RichardBenear/DDScopeX-Hardware/README.md

# DDScope-Hardware
Hardware documentation for Direct Drive Scope

## Book: BUILD A DIRECT DRIVE TELESCOPE: A Comprehensive Guide
Book Available on Amazon [Here](https://a.co/d/0cUrQWGB) 

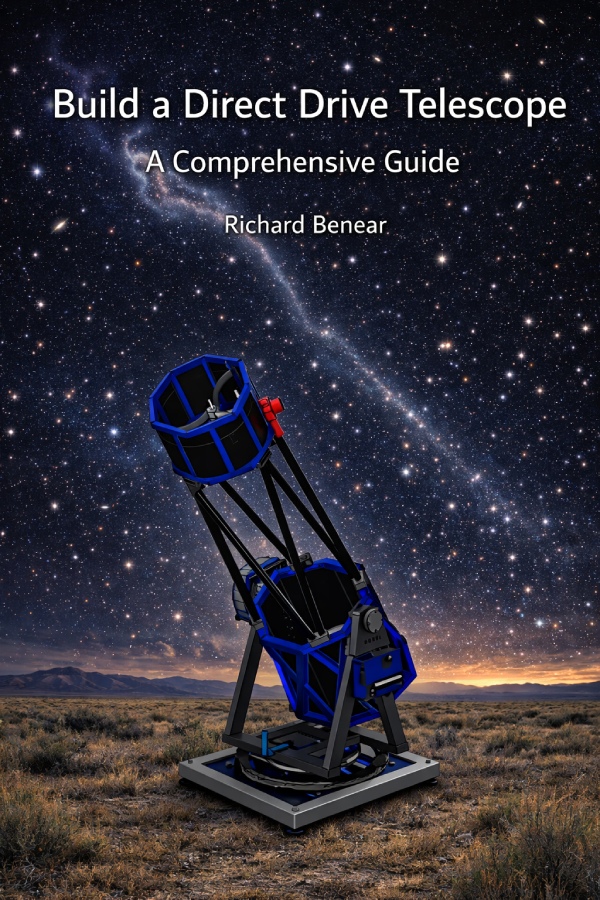
[picture p1: DDScopeXBookFront.jpg]
DDScopeX Book Front
