RichardBenear/DDScopeX-Hardware/ALT_Motor/dualAltMotor.JPG

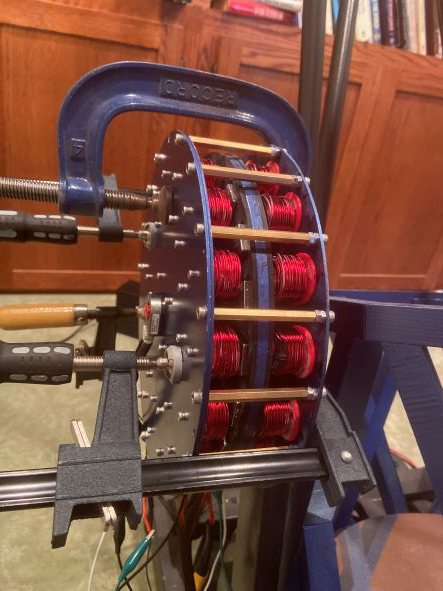
ALT_Motor/dualAltMotor.JPG
