RichardBenear/DDScopeX-Hardware/ALT_Motor/dualAltMotorFrame.JPG

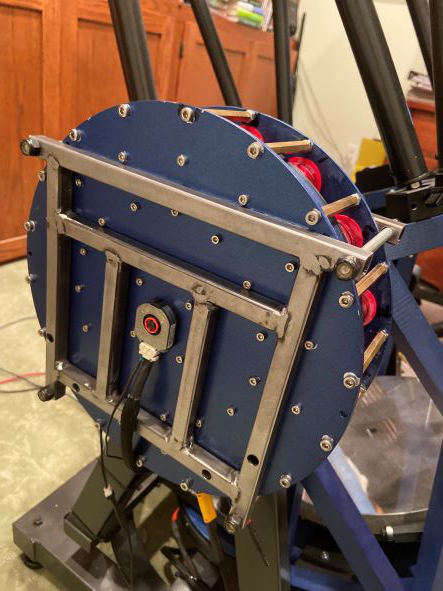
ALT_Motor/dualAltMotorFrame.JPG
