RichardBenear/DDScopeX-Hardware/ALT_Motor/dualAltMotorPart1.JPG

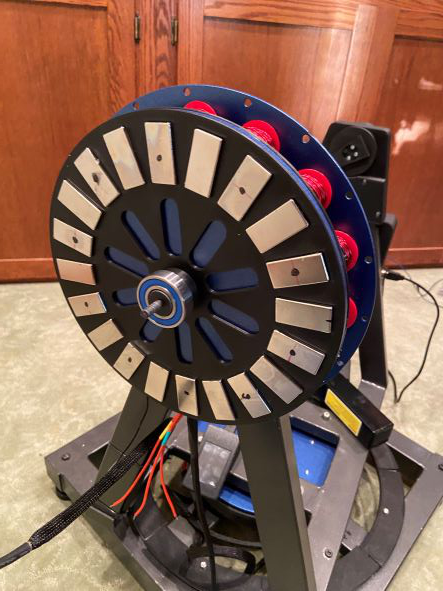
ALT_Motor/dualAltMotorPart1.JPG
