RichardBenear/DDScopeX-Hardware/ALT_Motor/dualAltMotorPart2.JPG

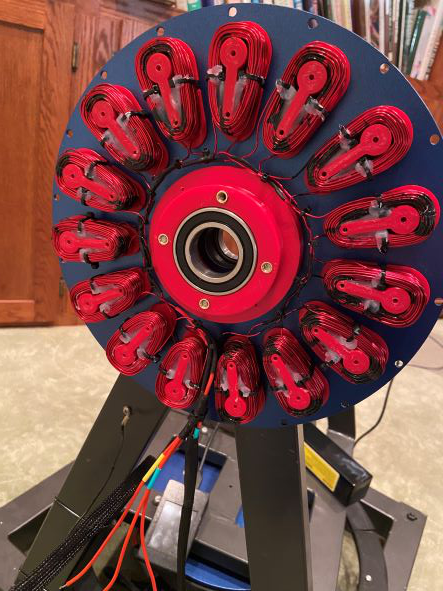
ALT_Motor/dualAltMotorPart2.JPG
