RichardBenear/DDScopeX-Hardware/ALT_Motor/dualAltMotorPart.JPG

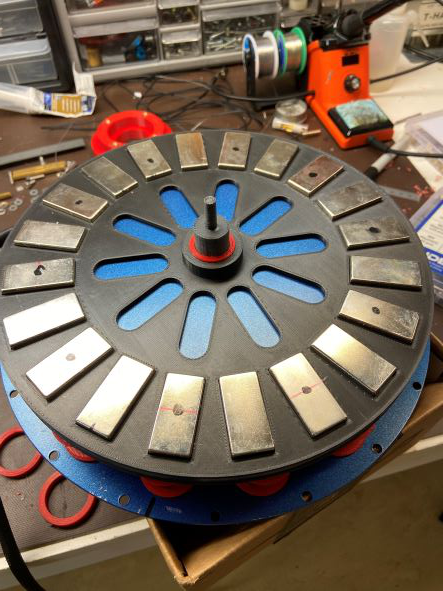
ALT_Motor/dualAltMotorPart.JPG
