RichardBenear/DDScopeX-Hardware/AZM_Motor/bottom.JPG

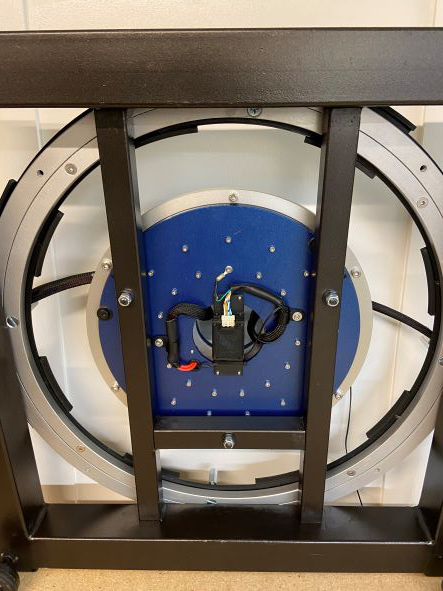
AZM_Motor/bottom.JPG
