RichardBenear/DDScopeX-Hardware/AZM_Motor/coils.JPG

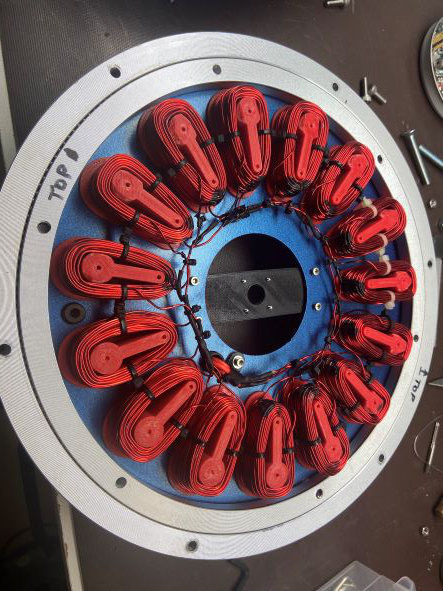
AZM_Motor/coils.JPG
