RichardBenear/DDScopeX-Hardware/AZM_Motor/magnets.JPG

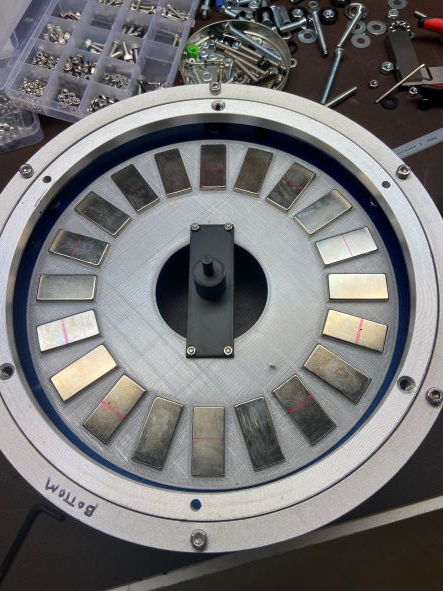
AZM_Motor/magnets.JPG
