RichardBenear/DDScopeX-Hardware/PCB/DD_Scope_PCBv3_bottom.jpg

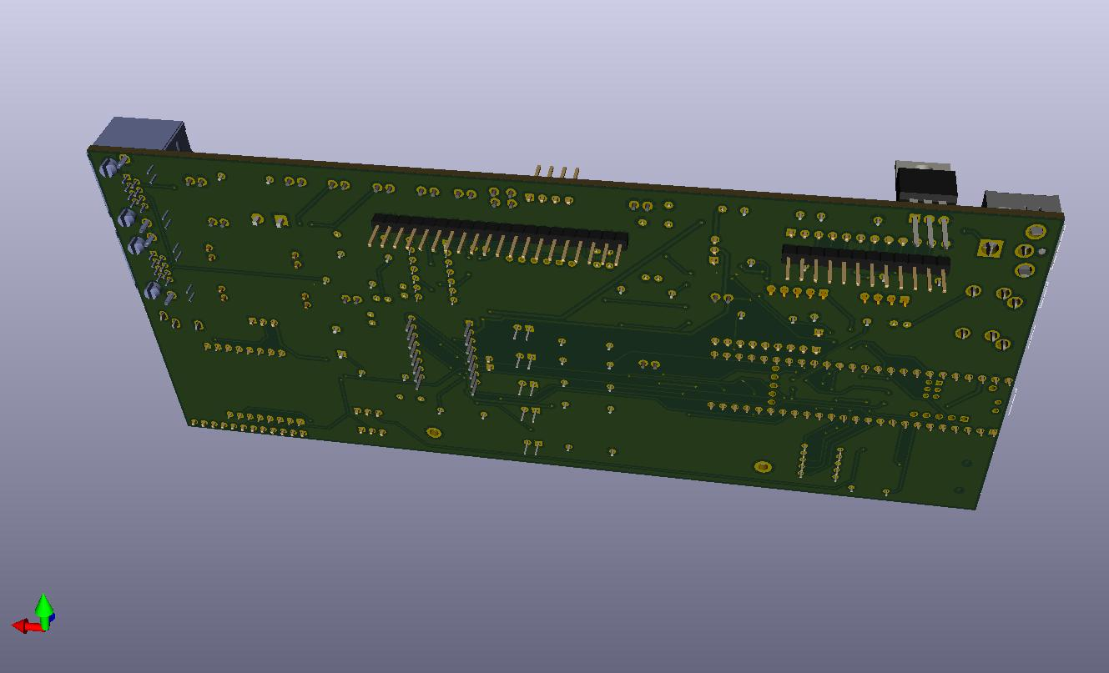
PCB/DD_Scope_PCBv3_bottom.jpg
