RichardBenear/DDScopeX-Hardware/PCB/DD_Scope_PCBv3_top.jpg

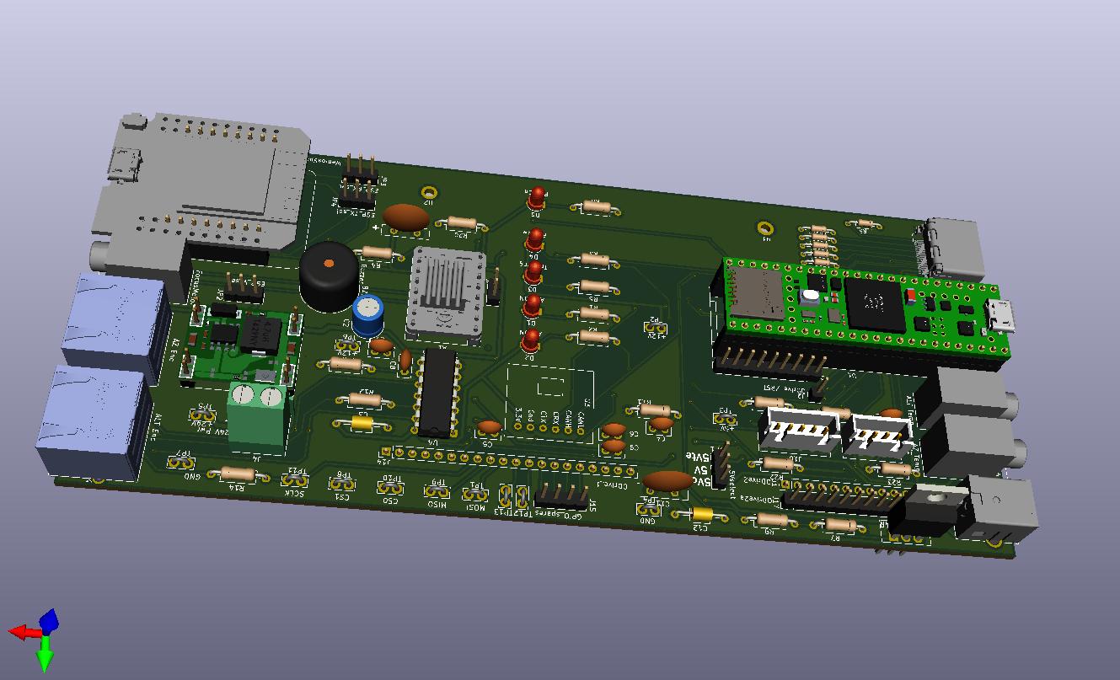
PCB/DD_Scope_PCBv3_top.jpg
