RichardBenear/DDScopeX-Hardware/PCB/DD_Scope_PCBv3_sch.pdf

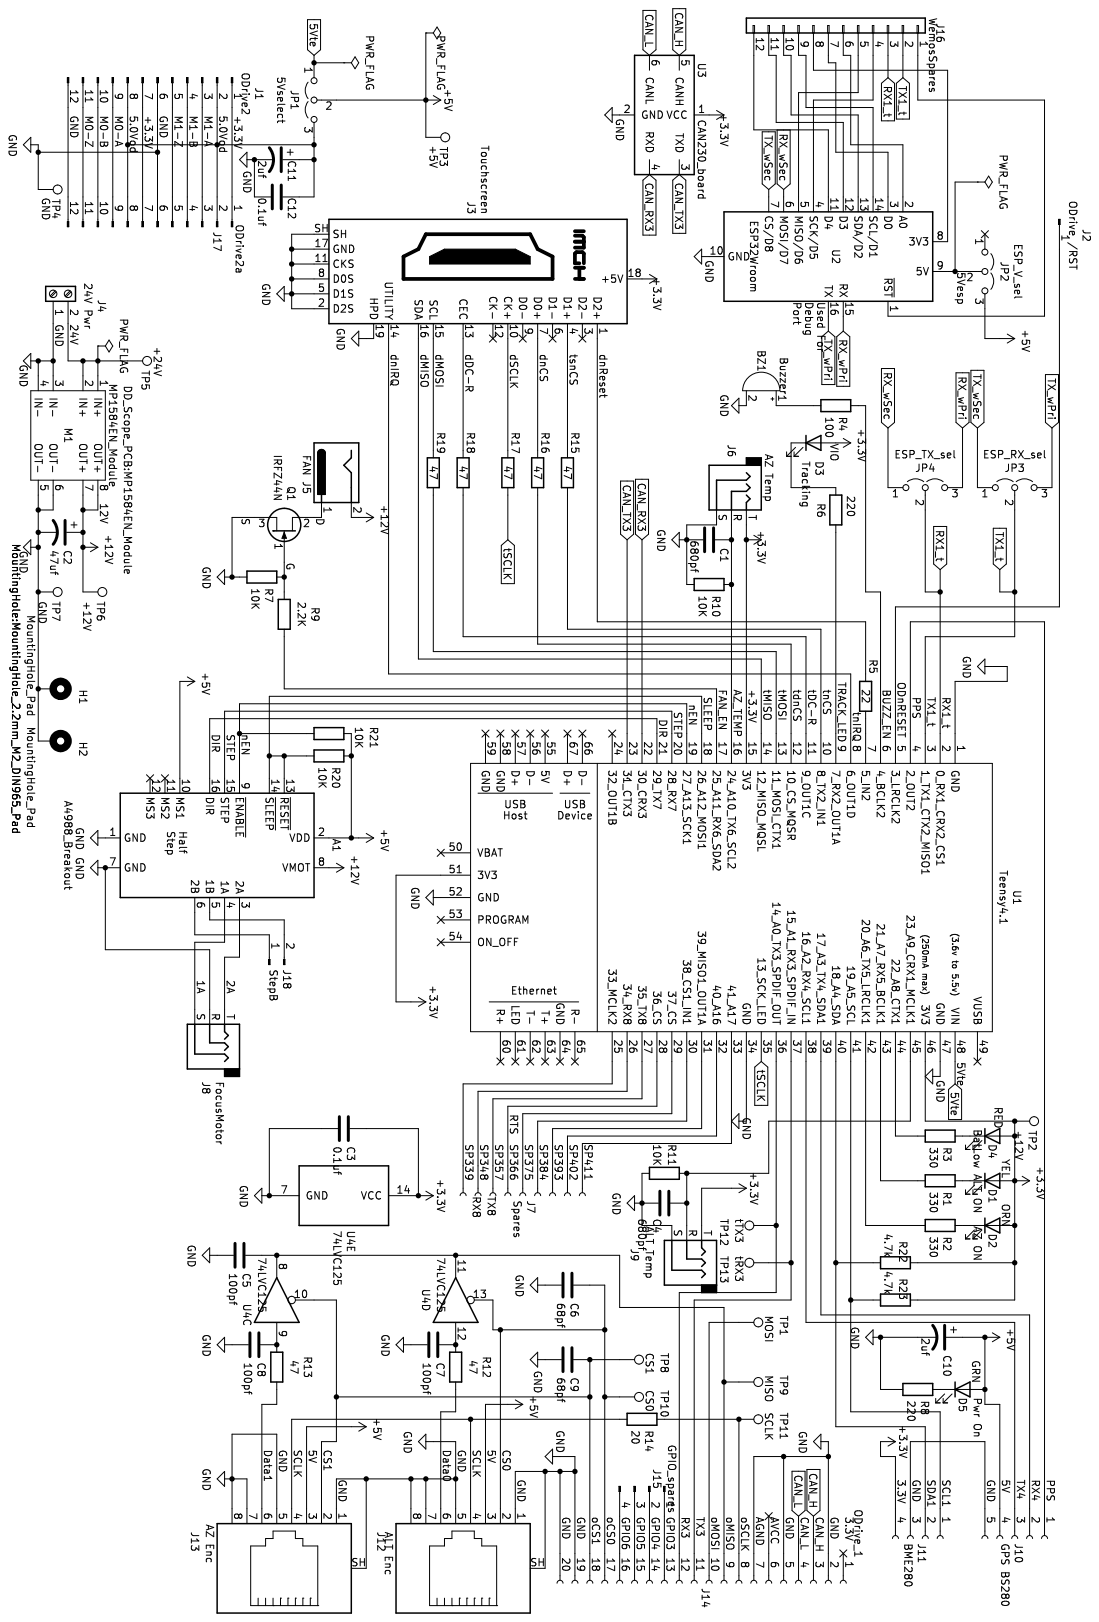
[picture p15: page 1]
