RichardBenear/DDScopeX-Hardware/PCB/DD_Scope_PCBv3_top.pdf

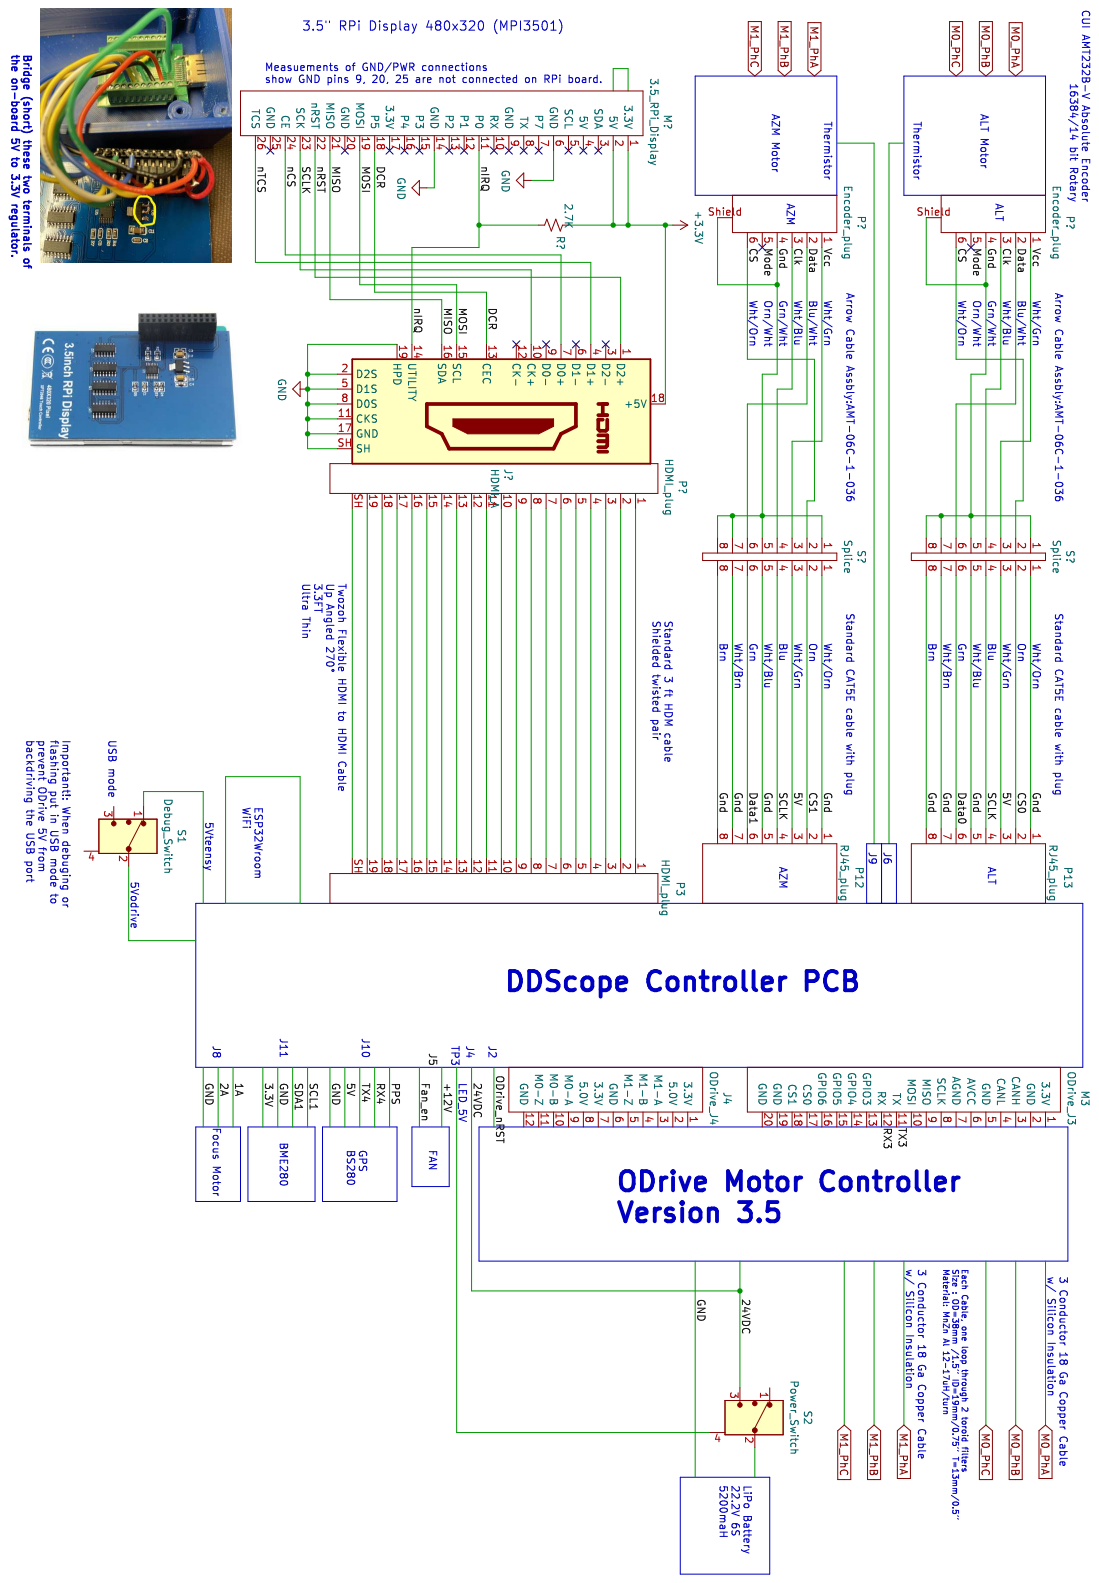
[picture p16: page 1]
