RichardBenear/DDScopeX-Hardware/PCB/DD_Scope_PCBv3.kicad_pcb

## KiCad design PCB/DD_Scope_PCBv3.kicad_pcb (2022-08-31)

Schematic: DD_Scope_PCBv3.sch, DD Scope Controller

Parts:
A1: A4988_Breakout; Pololu_Breakout-16_15.2x20.3mm
BZ1: Buzzer; Buzzer_12x9.5RM7.6
C1, C4: 680pf; C_Disc_D5.0mm_W2.5mm_P2.50mm
C2: 47uf; C_Radial_D6.3mm_H7.0mm_P2.50mm
C3, C12: 0.1uf; C_Axial_L3.8mm_D2.6mm_P10.00mm_Horizontal
C5, C7, C8: 100pf; C_Disc_D5.0mm_W2.5mm_P2.50mm
C6, C9: 68pf; C_Disc_D5.0mm_W2.5mm_P2.50mm
C10, C11: 2uf; C_Disc_D10.0mm_W2.5mm_P5.00mm
D1: ALT ON; LED_D3.0mm
D2: AZ ON; LED_D3.0mm
D3: Tracking; LED_D3.0mm
D4: BatLow; LED_D3.0mm
D5: Pwr On; LED_D3.0mm
H1, H2: MountingHole
J1: ODrive2; PinHeader_1x12_P2.54mm_Vertical
J2: ODrive /RST; PinHeader_1x01_P2.54mm_Vertical
J3: Touchscreen; HDMI_A_Female_2000-1-2-41-00-BK
J4: 24V Pwr; TerminalBlock_Phoenix_MKDS-1,5-2-5.08_1x02_P5.08mm_Horizont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
J5: FAN; BarrelJack_CUI_PJ-063AH_Horizontal_CircularHoles
J6: AZ Temp; Jack_3.5mm_CUI_SJ1-3533NG_Horizontal_CircularHoles
J7: Spares; PinHeader_1x09_P2.54mm_Vertical
J8: FocusMotor; Jack_3.5mm_CUI_SJ1-3533NG_Horizontal
J9: ALT Temp; Jack_3.5mm_CUI_SJ1-3533NG_Horizontal_CircularHoles
J10: GPS BS280; Molex_SPOX_5267-05A_1x05_P2.50mm_Vertical
J11: BME280; Molex_SPOX_5267-04A_1x04_P2.50mm_Vertical
J12: ALT Enc; RJ45_Amphenol_RJHSE5380
J13: AZ Enc; RJ45_Amphenol_RJHSE5380
J14: ODrive_1; PinHeader_1x20_P2.54mm_Vertical
J15: GPIO_spares; PinHeader_1x04_P2.54mm_Vertical
J16: WemosSpares; PinHeader_1x12_P2.54mm_Vertical
J17: ODrive2a; PinHeader_1x12_P2.54mm_Vertical
J18: StepB; PinHeader_1x02_P2.54mm_Vertical
JP1: 5Vselect; PinHeader_1x03_P2.54mm_Vertical
JP2: ESP_V_sel; PinHeader_1x03_P2.54mm_Vertical
JP3: ESP_RX_sel; PinHeader_1x03_P2.54mm_Vertical
JP4: ESP_TX_sel; PinHeader_1x03_P2.54mm_Vertical
M1: MP1584EN_Module
Q1: IRFZ44N; TO-220-3_Vertical
R1, R2, R3, R6, R8: 220; R_Axial_DIN0207_L6.3mm_D2.5mm_P10.16mm_Horizontal
R4: 100; R_Axial_DIN0207_L6.3mm_D2.5mm_P10.16mm_Horizontal
R5: 22; R_Axial_DIN0204_L3.6mm_D1.6mm_P7.62mm_Horizontal
R7, R10, R11, R20, R21: 10K; R_Axial_DIN0207_L6.3mm_D2.5mm_P10.16mm_Horizontal
R9: 2.2K; R_Axial_DIN0207_L6.3mm_D2.5mm_P10.16mm_Horizontal
R12, R13: 50; R_Axial_DIN0207_L6.3mm_D2.5mm_P10.16mm_Horizontal
R14: 20; R_Axial_DIN0207_L6.3mm_D2.5mm_P10.16mm_Horizontal
R15, R16, R17, R18, R19: 47; R_Axial_DIN0204_L3.6mm_D1.6mm_P7.62mm_Horizontal
R22, R23: 4.7k; R_Axial_DIN0207_L6.3mm_D2.5mm_P10.16mm_Horizontal
TP1: MOSI; TestPoint_Bridge_Pitch2.54mm_Drill1.0mm
TP2, TP6: +12V; TestPoint_Bridge_Pitch2.54mm_Drill1.0mm
TP3: +5V; TestPoint_Bridge_Pitch2.54mm_Drill1.0mm
TP4, TP7: GND; TestPoint_Bridge_Pitch2.54mm_Drill1.0mm
TP5: +24V; TestPoint_Bridge_Pitch2.54mm_Drill1.0mm
TP8: CS1; TestPoint_Bridge_Pitch2.54mm_Drill1.0mm
TP9: MISO; TestPoint_Bridge_Pitch2.54mm_Drill1.0mm
TP10: CS0; TestPoint_Bridge_Pitch2.54mm_Drill1.0mm
TP11: SCLK; TestPoint_Bridge_Pitch2.54mm_Drill1.0mm
TP12: tTX3; TestPoint_Bridge_Pitch2.54mm_Drill1.0mm
TP13: tRX3; TestPoint_Bridge_Pitch2.54mm_Drill1.0mm
U1: Teensy4.1; Teensy41
U2: ESP32Wroom; WEMOS_D1_mini_light
U3: CAN230_board
U4: 74LVC125; DIP-14_W7.62mm

Connections:
5Vte: JP1.1, U1.48
+3V3: C3.1, D1.2, D2.2, D3.2, D4.2, J1.1, J1.7, J3.18, J6.T, J9.T, J11.4, J17.1, J17.7, R22.1, R23.1, TP2.1, U1.15, U1.46, U1.51, U3.1 (VCC), U4.14
+5V: A1.2 (VDD), A1.10 (MS1), C10.1, D5.2, J10.4, J12.3, J13.3, JP1.2, JP2.3, R20.1, R21.1, TP3.1
+12V: A1.8 (VMOT), C2.1, J5.2, M1.7 (OUT+), M1.8 (OUT+), TP6.1
/1A: A1.4 (1A), J8.S
/2A: A1.3 (2A), J8.T
/5.0Vod: C11.1, C12.1, J1.2, J1.8, J17.2, J17.8, JP1.3
/5Vesp: JP2.2, U2.9
/24V: J4.2, M1.1 (IN+), M1.2 (IN+), TP5.1
/AZ_TEMP: C1.1, J6.R, R10.1, U1.16
/BUZZ_EN: R4.1, U1.6
/CS0: C6.1, J12.2, J14.17, TP10.1, U4.13
/CS1: C9.1, J13.2, J14.18, TP8.1, U4.10
/D: J5.1, Q1.2
/DIR: A1.16 (DIR), U1.21
/Data0: J12.6, R12.1
/Data1: J13.6, R13.1
/FAN_EN: R9.1, U1.17
/G: Q1.1, R7.1, R9.2
/GPIO3: J14.13, J15.1
/GPIO4: J14.14, J15.2
/GPIO5: J14.15, J15.3
/GPIO6: J14.16, J15.4
/M0-A: J1.9, J17.9
/M0-B: J1.10, J17.10
/M0-Z: J1.11, J17.11
/M1-A: J1.3, J17.3
/M1-B: J1.4, J17.4
/M1-Z: J1.5, J17.5
/ODnRESET: J2.1, U1.5
/PPS: J10.1, U1.4
/RX3: J14.12, TP12.1, U1.36
/RX4: J10.2, U1.39
/SCL1: J11.1, R23.2, U1.41
/SCLK: J12.4, J13.4, R14.2
/SDA1: J11.2, R22.2, U1.40
/SLEEP: A1.13 (~RESET), A1.14 (~SLEEP), R20.2, U1.18
/SP33: J7.9, U1.25
/SP34: J7.8, U1.26
/SP35: J7.7, U1.27
/SP36: J7.6, U1.28
/SP37: J7.5, U1.29
/SP38: J7.4, U1.30
/SP39: J7.3, U1.31
/SP40: J7.2, U1.32
/SP41: J7.1, U1.33
/STEP: A1.15 (STEP), U1.20
/TRACK_LED: R6.1, U1.9
/TX3: J14.11, TP13.1, U1.37
/TX4: J10.3, U1.38
/dDC-R: J3.13, R18.2
/dMISO: J3.16, U1.14
/dMOSI: J3.15, R19.2
/dSCLK: J3.10, R17.2
/dnCS: J3.7, R16.2
/dnIRQ: J3.14, U1.8
/dnReset: J3.1, R5.2
/nEN: A1.9 (~ENABLE), R21.2, U1.19
/oMISO: C5.1, J14.9, TP9.1, U4.8, U4.11
/oMOSI: J14.10, TP1.1
/oSCLK: J14.8, R14.1, TP11.1
/tDC-R: R18.1, U1.11
/tMOSI: R19.1, U1.13
/tdnCS: R16.1, U1.12
/tnCS: R15.1, U1.10
/tsnCS: J3.4, R15.2
CAN_H: J14.3, U3.5 (CANH)
CAN_L: J14.4, U3.6 (CANL)
CAN_RX3: U1.22, U3.4 (RXD)
CAN_TX3: U1.23, U3.3 (TXD)
GND: A1.1 (GND), A1.7 (GND), BZ1.2, C1.2, C2.2, C3.2, C4.2, C5.2, C6.2, C7.2, C8.2, C9.2, C10.2, C11.2, C12.2, H1.1, H2.1, J1.6, J1.12, J3.2, J3.5, J3.8, J3.11, J3.17, J3.19, J3.SH, J4.1, J6.S, J8.R, J9.S, J10.5, J11.3, J12.1, J12.5, J12.7, J12.8, J12.SH, J13.1, J13.5, J13.7, J13.8, J13.SH, J14.2, J14.5, J14.7, J14.19, J14.20, J17.6, J17.12, M1.3 (IN-), M1.4 (IN-), M1.5 (OUT-), M1.6 (OUT-), Q1.3, R7.2, R8.2, R10.2, R11.2, TP4.1, TP7.1, U1.1, U1.34, U1.47, U1.52, U2.10, U3.2 (GND), U4.7
unnamed: A1.5 (1B), J18.2
unnamed: A1.6 (2B), J18.1
unnamed: BZ1.1, R4.2
unnamed: C4.1, J9.R, R11.1, U1.45
unnamed: C7.1, R12.2, U4.12
unnamed: C8.1, R13.2, U4.9
unnamed: D1.1, R1.1
unnamed: D2.1, R2.1
unnamed: D3.1, R6.2
unnamed: D4.1, R3.1
unnamed: D5.1, R8.1
unnamed: J16.1, U2.1
unnamed: J16.4, U2.4
unnamed: J16.5, U2.5
unnamed: J16.6, U2.2
unnamed: J16.7, U2.3
unnamed: J16.8, U2.8
unnamed: J16.9, U2.14
unnamed: J16.10, U2.13
unnamed: J16.11, U2.12
unnamed: J16.12, U2.11
unnamed: R1.2, U1.43
unnamed: R2.2, U1.42
unnamed: R3.2, U1.44
unnamed: R5.1, U1.7
RX1_t: J16.3, JP4.2, U1.2
RX_wPri: JP3.3, U2.15
RX_wSec: JP3.1, U2.7
TX1_t: J16.2, JP3.2, U1.3
TX_wPri: JP4.3, U2.16
TX_wSec: JP4.1, U2.6
tSCLK: R17.1, U1.35

Notes on the sheet:
3.3V

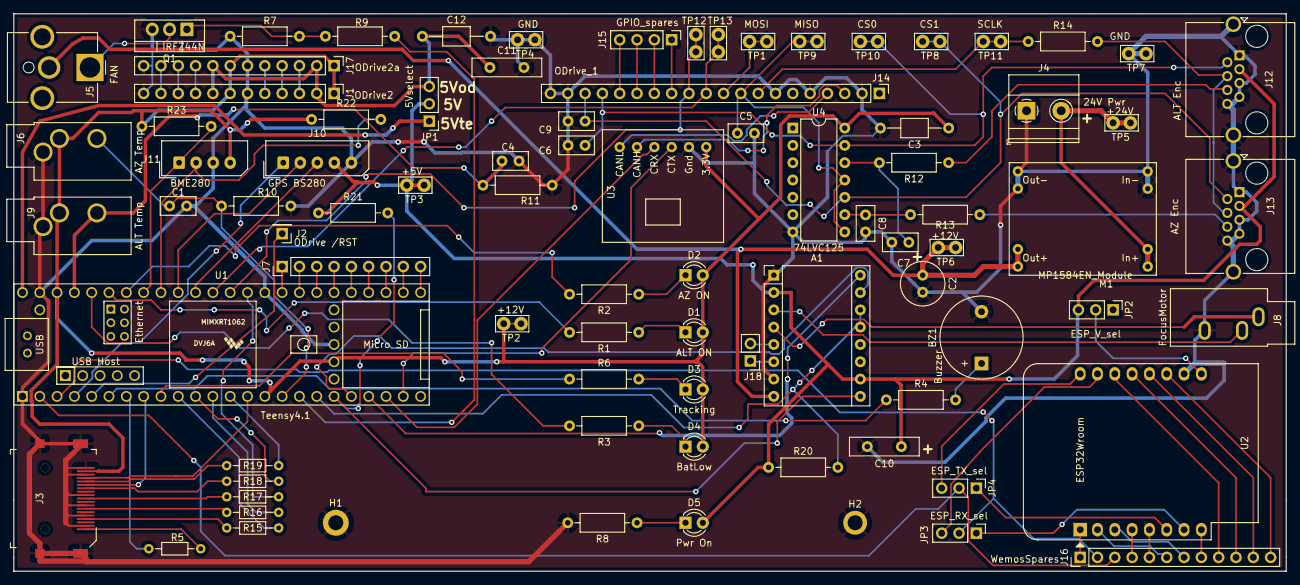
[picture p17: board DD_Scope_PCBv3.kicad_pcb from above]

Board: 2 copper layers, 186.7 x 81.8 mm, 85 parts (0 on the bottom side), 103 nets.
