RichardBenear/DDScopeX-Hardware/(commit log)

2023-02-22 corrected GPIO pin number for CS0
2026-02-13 Corrected errors ODrive configuration settings and procedures
2026-02-13 Enhance ODrive setup instructions for motors
    Added detailed ODrive motor configuration settings and calibration procedures for both altitude and azimuth motors, including anticogging setup and startup procedures.
2026-02-21 updated with corrections -compatible with KiCad7
2026-02-21 Delete DDScope_TopLevel.pdf
    newer version in PCB folder
