RichardBenear/DDScopeX-Hardware/controller_insides_v3.jpg

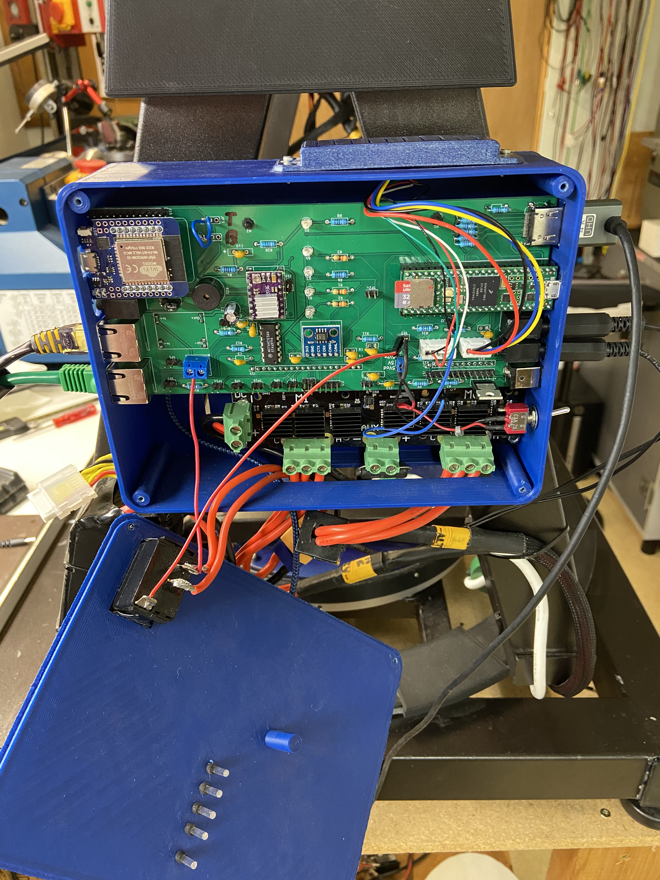
controller_insides_v3.jpg
