RichardBenear/DDScopeX-Hardware/controller_left_side.jpg

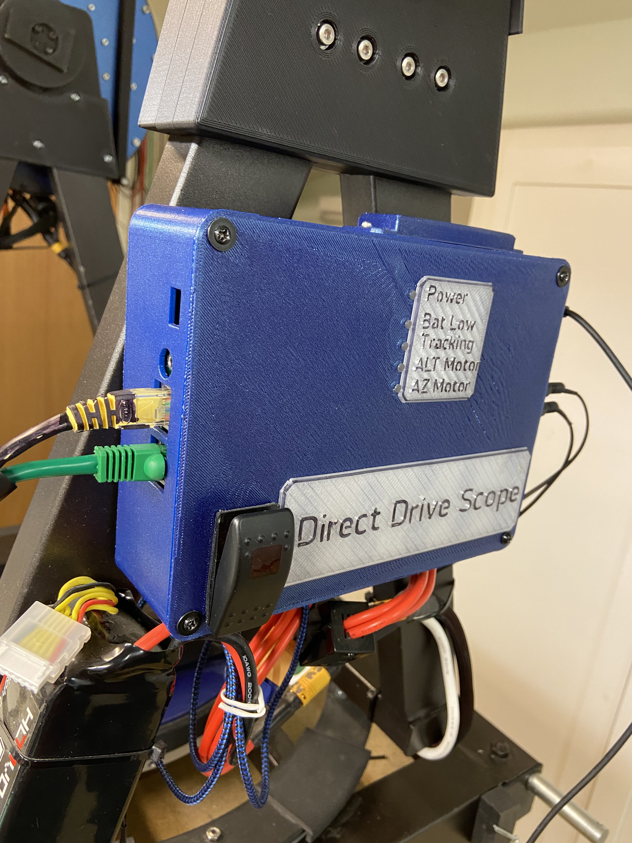
controller_left_side.jpg
