RichardBenear/DDScopeX-Hardware/controller_right_side.jpg

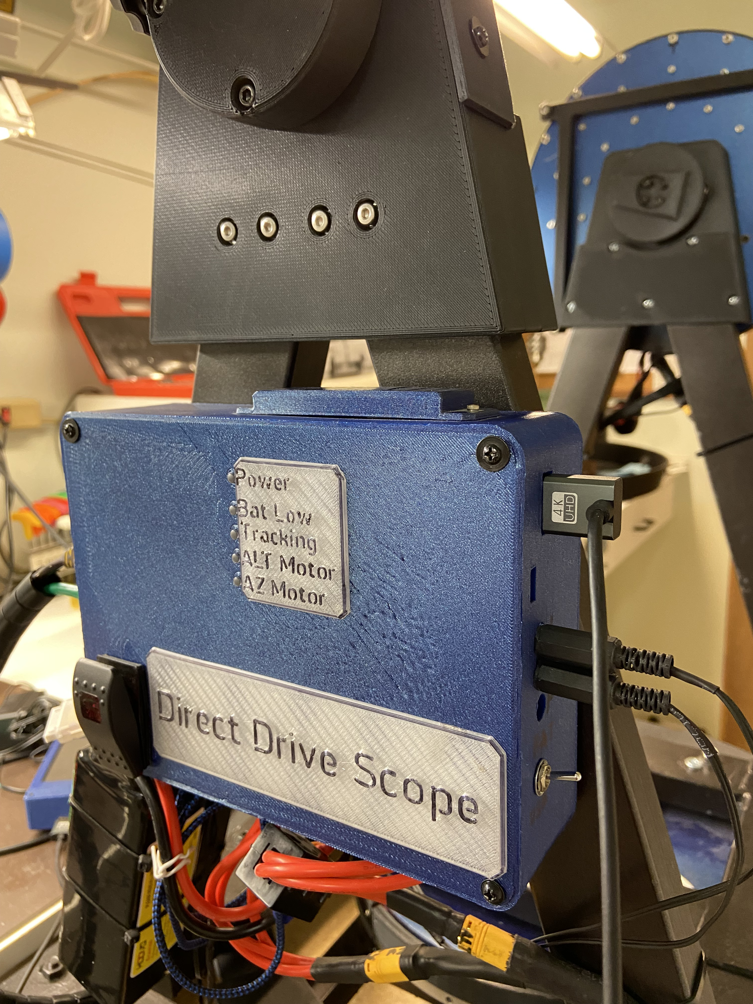
controller_right_side.jpg
